dungdz16/DATN_RTLS_Gateway/README.md

# DATN_RTLS_Gateway
Indoor Realtime Locating System use DWM1001
