dungdz16/DATN_RTLS_Gateway/Firmware/doc/RTLS Config Protocol.docx

# Cấu hình thiết bị sử dụng Smart config:

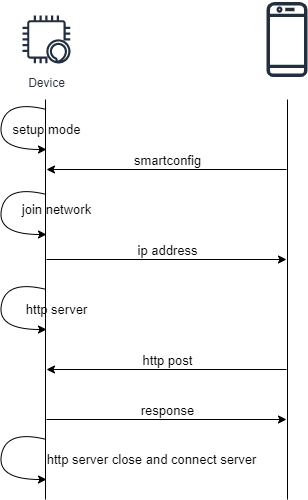
[picture p1: figure]

- Device sau khi nhận SSID và PWD, kết nối thành công vào mạng WiFi sẽ mở http server tại port80, app sẽ kết nối vào port này để truyền nhận dữ liệu.
- APP gửi GET method vào API /api/info để nhận thông tin về gateway bao gồm gateway_id, firmware_version, hardware_version, … APP sẽ check id của gateway để gửi đúng private key đã lưu trữ trên cloud cho gateway.
- APP gửi POST method vào các API sau để device lưu lại trong bộ nhớ.
  - /api/setup/project
  - /api/setup/cert
- Root ca và private_key: mã hóa Base64.
- Device close http server và connect đến cloud.

API | App | Device
/api/info | GET | HTTP OK { "id": {id}, "model": "{model}", "firmware": {fw}, "hardware": {hw}, "mac": "{mac}" }
/api/setup/project | POST { "host": "{host}", "port": {port}, "project_id": "{project_id}", "location": "{location}", "registry_id": "{registry_id}" } | HTTP OK
/api/setup/cert | POST { "root_ca": { "length": {ca_length}, "data":"{root_ca_data}" } "private_key": { "length": {private_key_length}, "data":"{private_key_data}" } } | HTTP OK
