dungdz16/DATN_RTLS_Gateway/Hardware/Datasheet/SmartGood-ENC28J60-Ethernet-LAN-Network-Module-Schematic-For-for-arduino-51-AVR-LPC.jpg_Q90.jpg_.webp

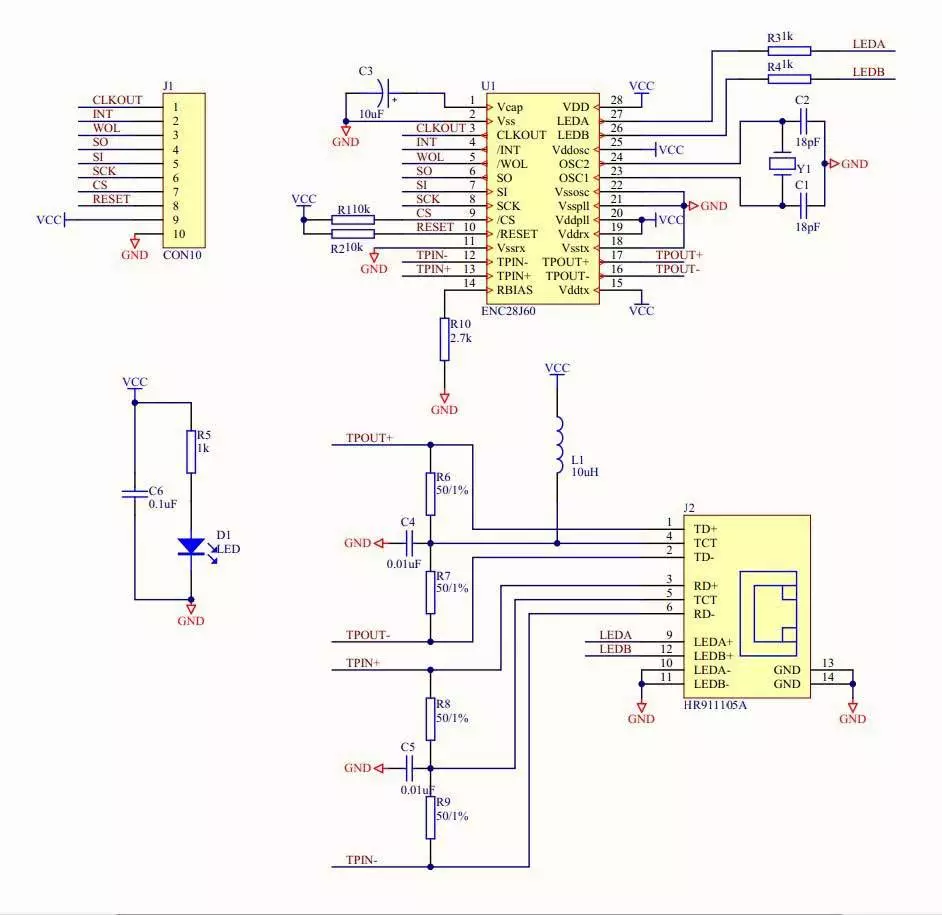
Hardware/Datasheet/SmartGood-ENC28J60-Ethernet-LAN-Network-Module-Schematic-For-for-arduino-51-AVR-LPC.jpg_Q90.jpg_.webp
