dungdz16/DATN_RTLS_Gateway/(list of files, drawings)

Other design files:
Hardware/Project/BLE_Gateway_V1.0.PrjPCB
Hardware/Project/Connection.SchDoc
Hardware/Project/Ethernet.SchDoc
Hardware/Project/External Flash.SchDoc
Hardware/Project/Logo.PcbDoc
Hardware/Project/MCU.SchDoc
Hardware/Project/Power Supply.SchDoc
